AgH2O/KS_Shield/frontlayout.pdf

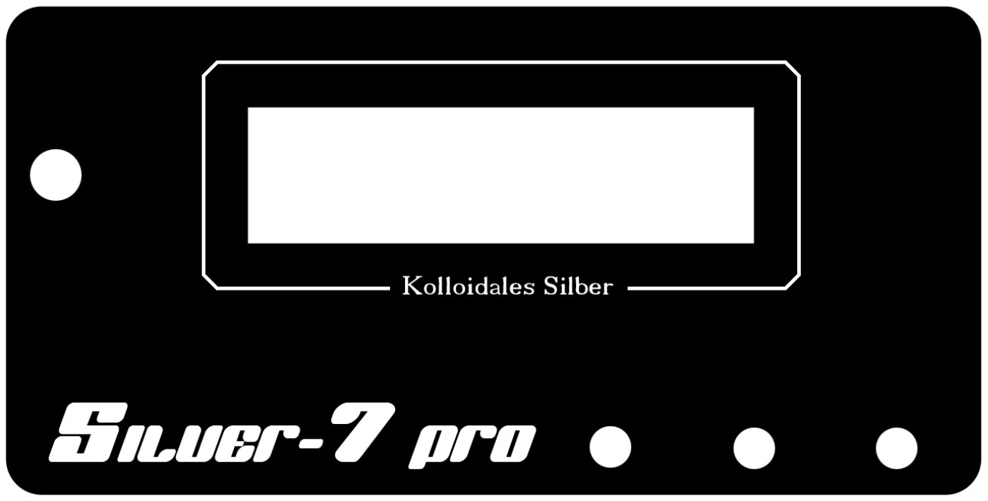
[picture p1: page 1]
