AgH2O/KS_Shield/stromvers_layout.pdf

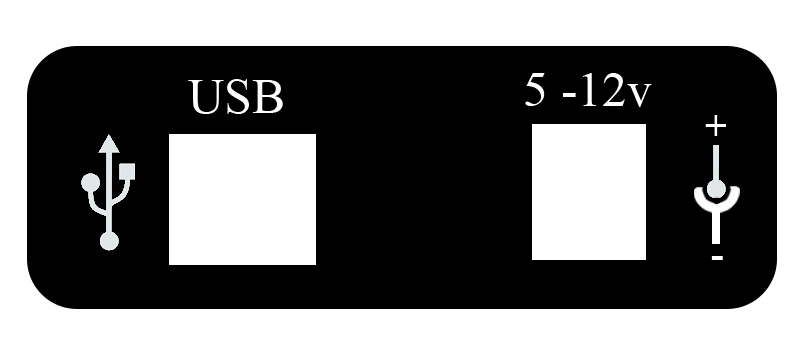
[picture p2: page 1]
