AgH2O/KS_Shield/Schaltplan.pdf

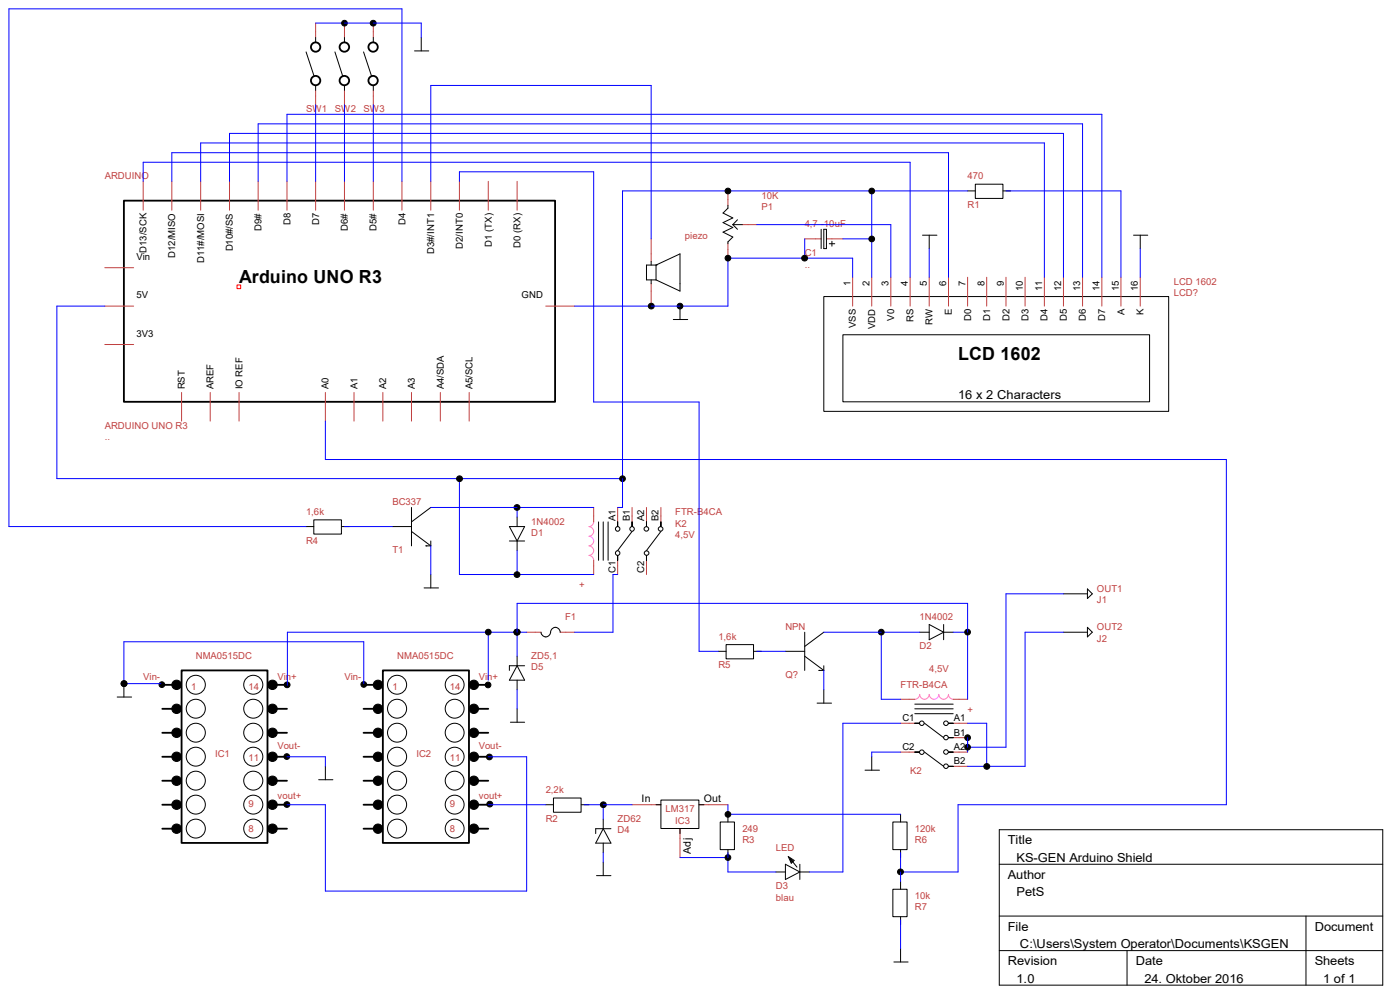
[picture p3: page 1]

KS-GEN Arduino Shield
Author
PetS

File C:\Users\System Operator\Documents\KSGEN | Document

Revision 1.0 | Date 24. Oktober 2016 | Sheets 1 of 1
