AgH2O/KS_Shield/KSGEN-Shunt-Version_Patch1.pdf

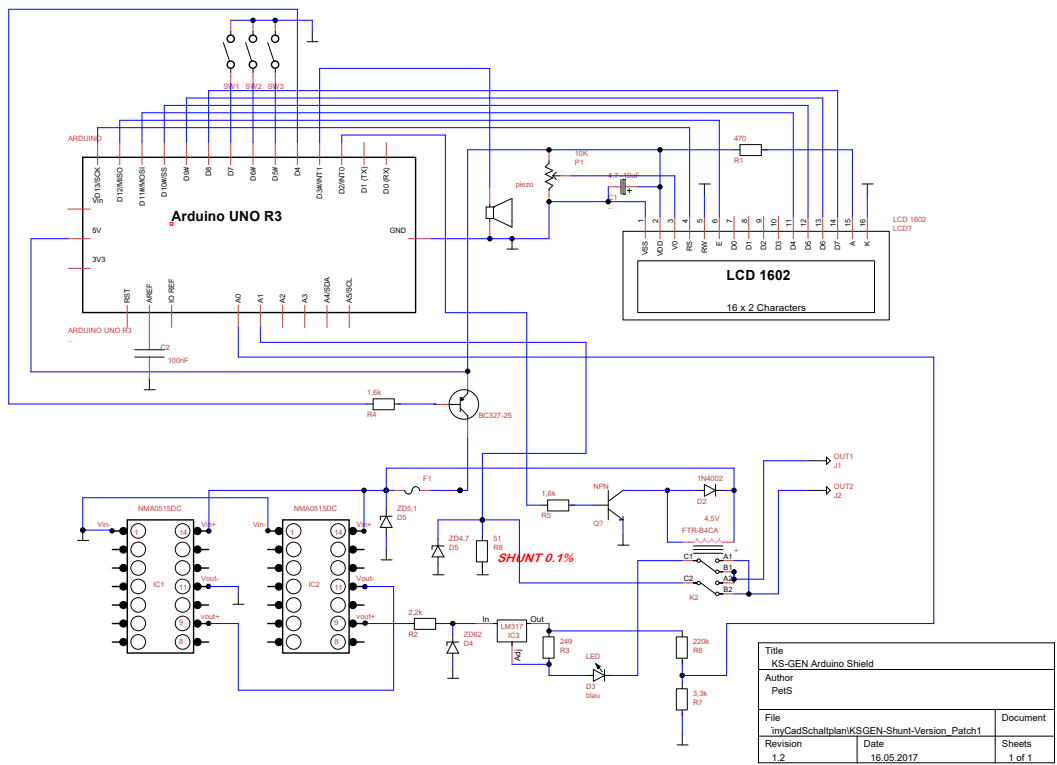
[picture p4: page 1]

File | Document
Revision 1.2 | Date 16.05.2017 | Sheets 1 of 1
