AgH2O/KS_Shield/KSGEN-Shunt-Version.pdf

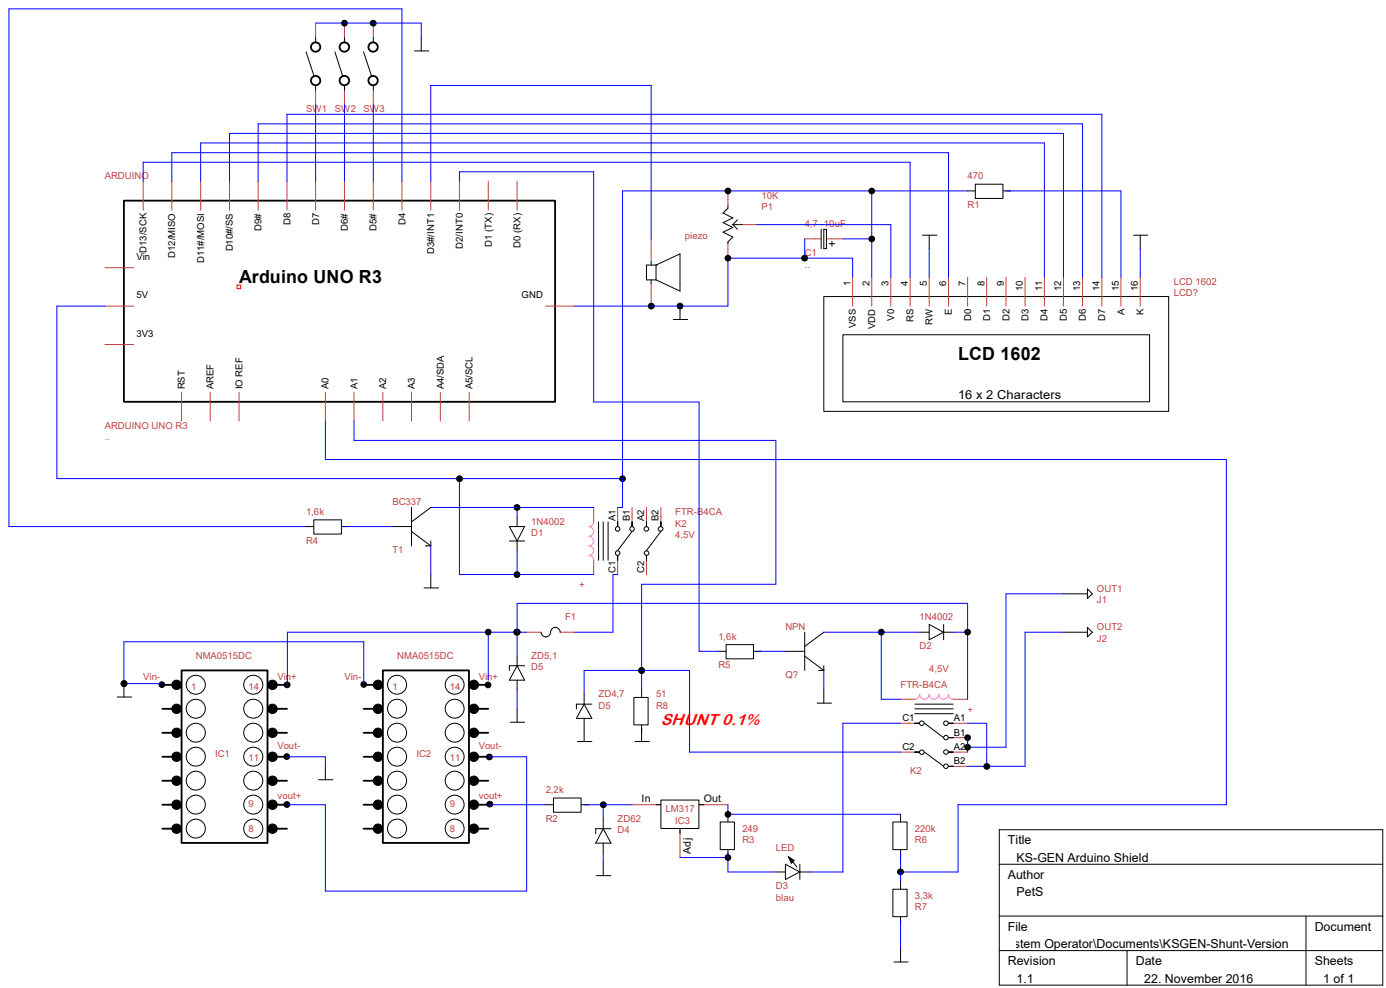
[picture p5: page 1]

C:\Users\System Operator\Documents\KSGEN-Shunt-Version
