AgH2O/KS_Shield/(list of files, drawings)

Other design files:
KS-GEN-Shield-V1-final_shunt.lay6
KS-GEN-Tasterpanel.lay6
