AgH2O/KS_Shield/(commit log)

2016-11-09 PolwechselZeit jetzt wählbar
    Neues drittes Menü zum wählen der Polwechselzeit im Bereich 0 bis 10 Minuten. Null bedeutet kein Wechsel
2016-11-09 Geziptes Sketch gelöscht
    Macht keinen Sinn, wenn am sketch noch programmiert wird und die Zipdatei auf einen alten Stand bleibt
2016-11-09 New Feature - Stop mit Taste 1 und 3
2017-01-18 final Version Upadtes and new remarks
    [KS-GEN-Shield-V1-final_rev02.lay6, KS-GEN-Shield-V1-final_shunt.lay6]
2017-05-16 Hard & Software Patch Nr.1 shunt version
    Das Relais K1, die Diode D1 und T1 der BC337 fallen komplett weg und werden durch einen BC327-25(PNP) ersetzt. Gleichzeitig muss die Ansteuerlogik invertiert werden.
    digitalWrite(START, HIGH); -->ist jetzt STOP
    digitalWrite(START, LOW); -->ist jetzt START
    Ausserdem ist jetzt ein 100nF Kondensator an AREF nach Masse dazu gekommen. Dadurch wird der Messwert ruhiger und störungsfreier.
    Danke an Markus W.
